sametyakut/EE464-TERM-RPOJECT/altium/component_side.jpeg

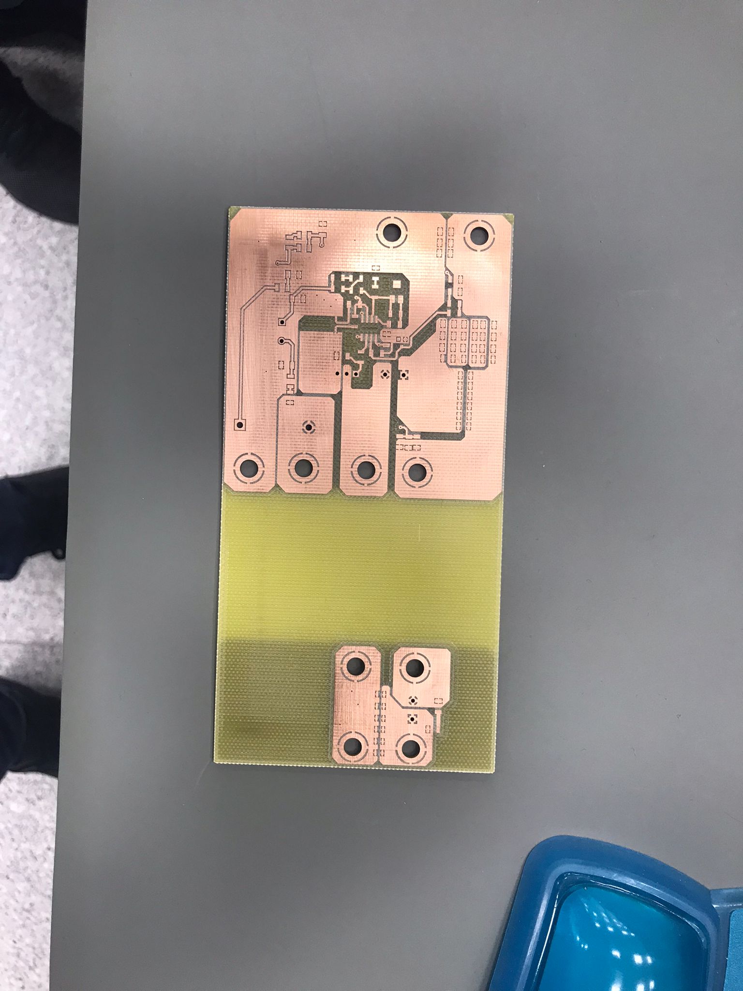
altium/component_side.jpeg
