sametyakut/EE464-TERM-RPOJECT/Magnetic Design/Magnetizing.jpg

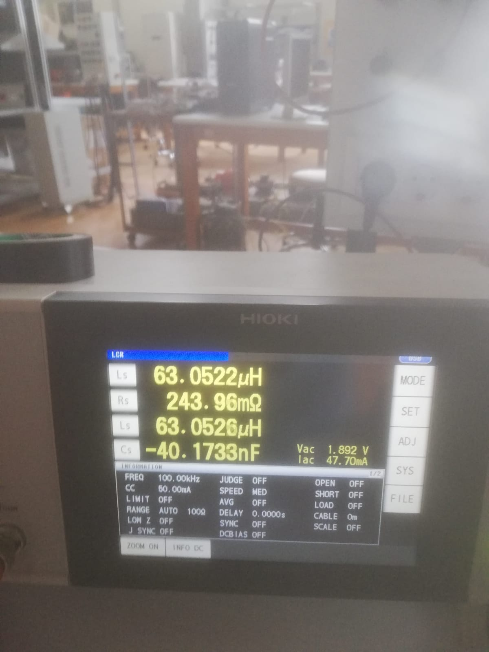
Magnetic Design/Magnetizing.jpg
