sametyakut/EE464-TERM-RPOJECT/Sim/Snubber design.xlsx

Vsn | 140.00
Lleak | 2.47e-06
Ipeak | 7.00
Vo | 16.00
fs | 44000.00
Psn | 3.01
Rsn | 6519.795993
