sametyakut/EE464-TERM-RPOJECT/altium/back_side.jpeg

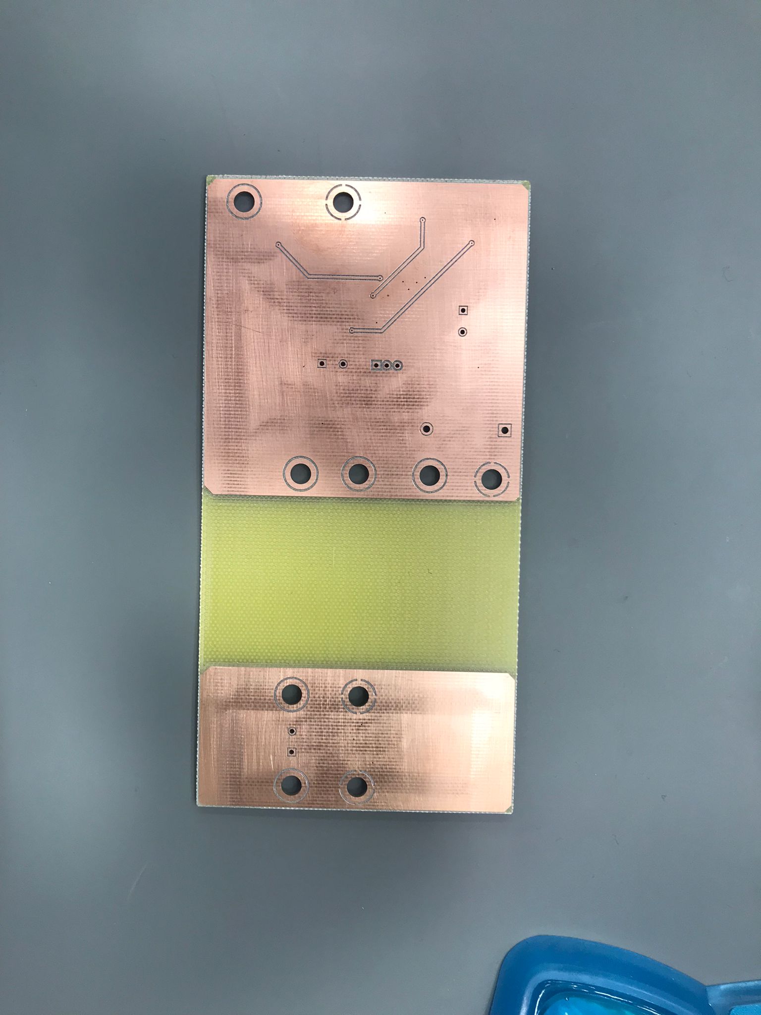
altium/back_side.jpeg
