sametyakut/EE464-TERM-RPOJECT/Magnetic Design/Leakage.jpg

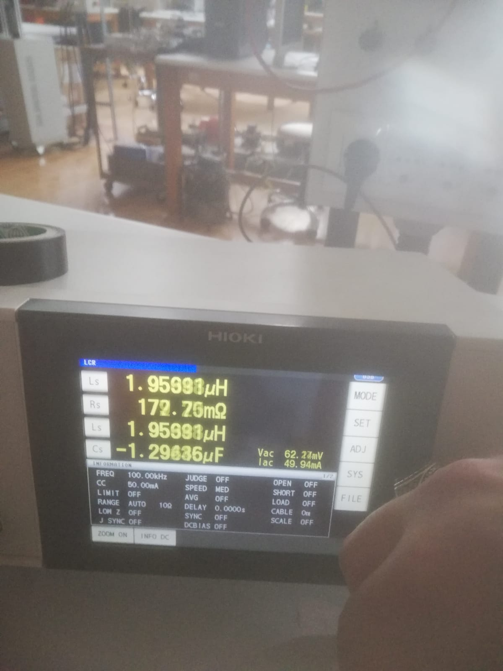
Magnetic Design/Leakage.jpg
