sametyakut/EE464-TERM-RPOJECT/Sim/schematic_jun_05.png

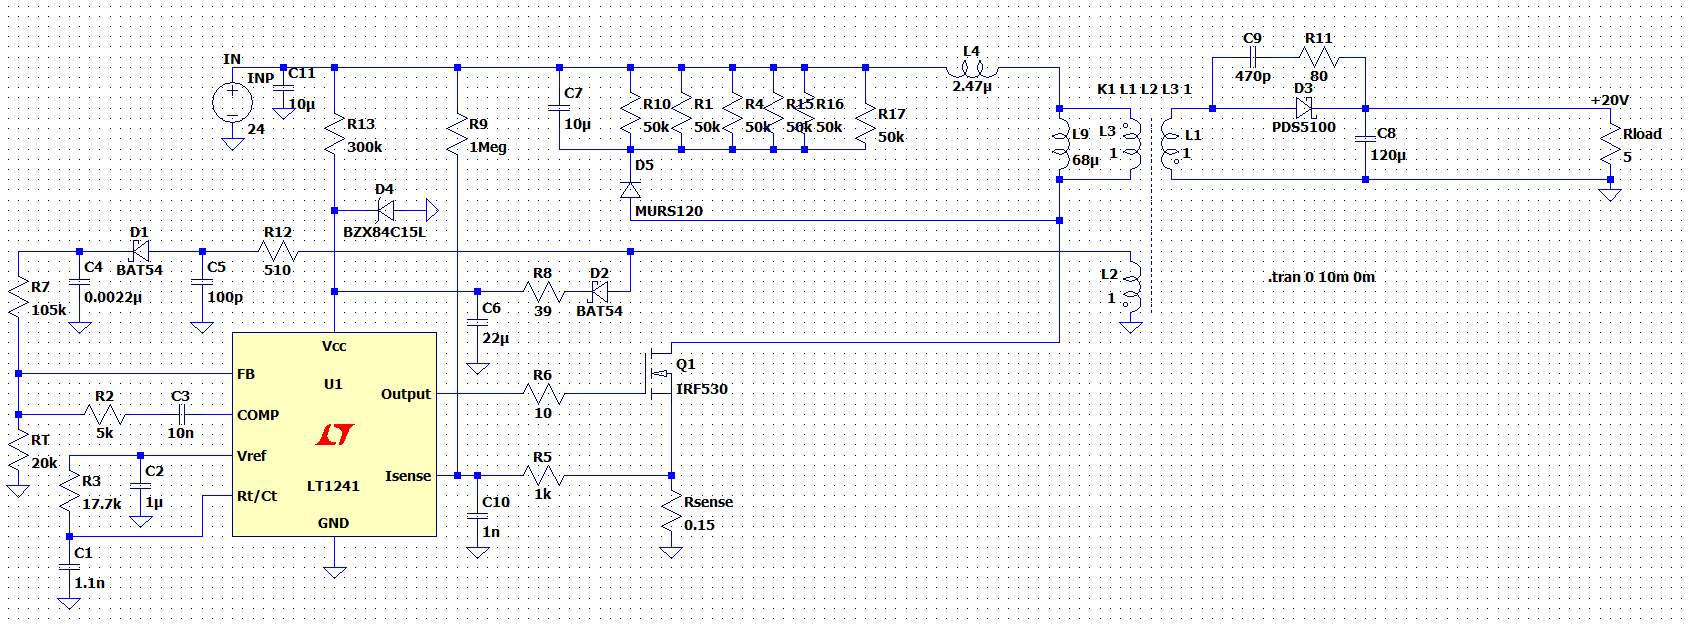
Sim/schematic_jun_05.png
