sametyakut/EE464-TERM-RPOJECT/Sim/UpdatedCircuit_Jun20.png

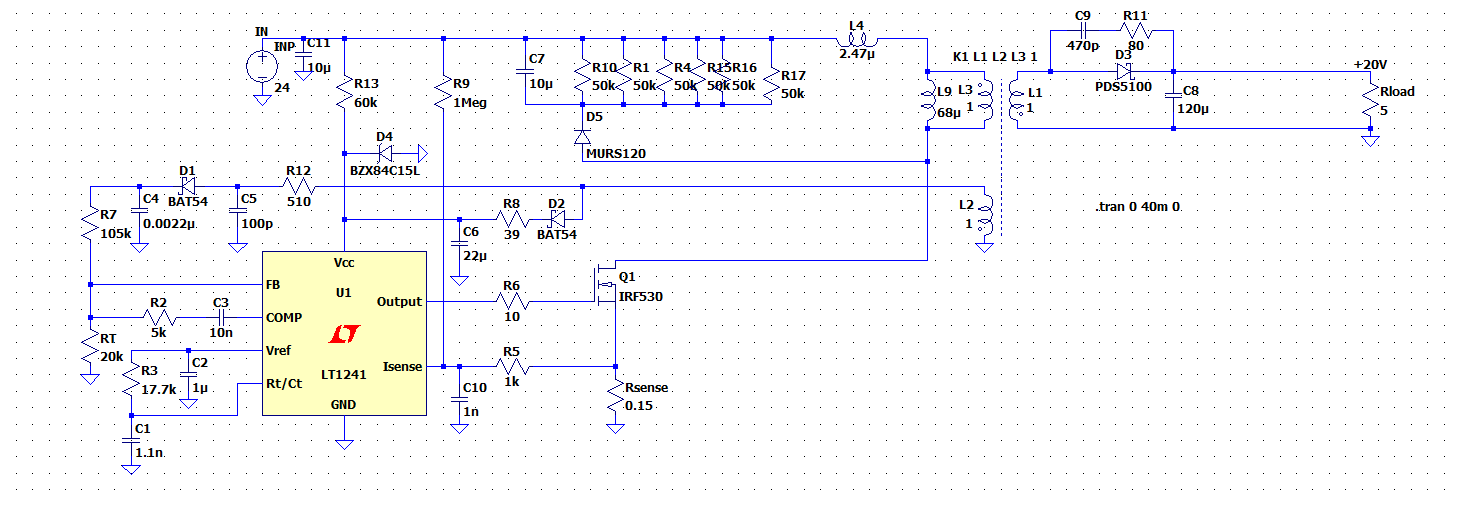
Sim/UpdatedCircuit_Jun20.png
