sametyakut/EE464-TERM-RPOJECT/altium/BOM.xlsx

Comment | Description | Designator | Footprint | LibRef | Quantity
1NF | CAP,1UF(16V,10%,CER,X7R,SMD-1206) | C1, C3 | 1206N | 10023689-135 | 2
1UF | CAP,1UF(16V,10%,CER,X7R,SMD-1206) | C2, C20 | 1206N | 10023689-135 | 2
2.2NF | CAP,1UF(16V,10%,CER,X7R,SMD-1206) | C4 | 1206N | 10023689-135 | 1
100PF | CAP,1UF(16V,10%,CER,X7R,SMD-1206) | C5,C10 | 1206N | 10023689-135 | 1
22UF | CAP,1UF(16V,10%,CER,X7R,SMD-1206) | C6 | 1206N | 10023689-135 | 1
10UF | CAP,1UF(16V,10%,CER,X7R,SMD-1206) | C7, C7_1, C7_2, C7_3, C7_4, C7_5, C7_6, C7_7, C7_8, C15, C15_2, C15_3, C17, C17_2, C17_3 | 1206N | 10023689-135 | 15
22UF | CAP,22UF(25VDC,20%,CER,X5R,SMD-0805) | C8, C9, C11, C12, C13, C14 | 0805L | 30000061 | 6
470PF | CAP,1UF(16V,10%,CER,X7R,SMD-1206) | C16 | 1206N | 10023689-135 | 1
100NF | CAP,1UF(16V,10%,CER,X7R,SMD-1206) | CG | 1206N | 10023689-135 | 1
MBR560 | Schottky Rectifier | D1 | TO-220AC | Diode 10TQ035 | 1
SR5100 | 3 Amp General Purpose Rectifier | D2 | DO-201AD | Diode 1N5401 | 1
MBR10100 | Schottky Rectifier | D3 | TO-220AC | Diode 10TQ035 | 1
BZX84C15LT1 | DIODE(ZNR,15V,SOT-23) | D4 | SOT23_190P290X240X111_3 | 5961-1315-0002 | 1
MBR10150 | Schottky Rectifier | D5 | TO-220AC | Diode 10TQ035 | 1
NMOS-2 | N-Channel Power MOSFET | Q1 | TO-220AB | NMOS-2 | 1
470M OHM | RES,3M(THFL,2W,1%,SMD-2512) | R1_1, R1_2, R1_3 | 2512N | 30007383 | 3
0 OHM | RES,0R(THFL,0.250W,0%,SMD-1206) | R2_1, R3_2, R7_1 | 1206L | 10023672-5 | 3
10K OHM | POT,10KR(CRMT_LIN,0.25W,10%,MULT,SMD) | R2_2 | pot_3224j | 5905-9993-1034 | 1
15K OHM | RES,0R(THFL,0.250W,0%,SMD-1206) | R3_1 | 1206L | 10023672-5 | 1
2.7K OHM | RES,0R(THFL,0.250W,0%,SMD-1206) | R3_3, R7_2, R7_3 | 1206L | 10023672-5 | 3
10K OHM | RES,0R(THFL,0.250W,0%,SMD-1206) | R4_1, R4_2 | 1206L | 10023672-5 | 2
1K OHM | RES,0R(THFL,0.250W,0%,SMD-1206) | R5 | 1206L | 10023672-5 | 1
10R OHM | RES,0R(THFL,0.250W,0%,SMD-1206) | R6 | 1206L | 10023672-5 | 1
100K OHM | RES,0R(THFL,0.250W,0%,SMD-1206) | R7_4, R13_1, R13_2, R13_3 | 1206L | 10023672-5 | 4
39R OHM | RES,0R(THFL,0.250W,0%,SMD-1206) | R8 | 1206L | 10023672-5 | 1
1MEG OHM | RES,0R(THFL,0.250W,0%,SMD-1206) | R9, R14_1, R14_2, R14_3 | 1206L | 10023672-5 | 4
47K OHM | RES,0R(THFL,0.250W,0%,SMD-1206) | R10_1, R10_2, R10_3, R10_4, R10_5, R10_6 | 1206L | 10023672-5 | 6
80 OHM | RES,0R(THFL,0.250W,0%,SMD-1206) | R11 | 1206L | 10023672-5 | 1
120R OHM | RES,0R(THFL,0.250W,0%,SMD-1206) | R12_1 | 1206L | 10023672-5 | 1
390R OHM | RES,0R(THFL,0.250W,0%,SMD-1206) | R12_2 | 1206L | 10023672-5 | 1
UC3845D8 | No Description Available | U1 | D8 | UC3845D8 | 1
