sametyakut/EE464-TERM-RPOJECT/components/component list.xlsx

Component | Value | DIRENC.NET
R1(RSense) | 0.3 | 3*0.1R
R2 | 10k | 1*10k
R3 | 3k(2952) | 15k+2.7k | Hesap Uc3845 göre değişti 17Kohm olacak
R4(RT) | 20k | 2*10k
R5 | 5k | 10k??
R6 | 12 | 10R
R7 | 102k | 100k+10k
R8 | 39 | 1*39R
R9 | 1meg | 1*1meg
R10 | 100k | 1*100k
R11 | Copper loss
R12 | 510 | 120R+390R
R13 | 300k | 3*100k
C1 | 1n/50V | 1*1n
C2 | 1u/50V | 1*1u
C3 | 10n/50V | 1*10n
C4 | 2.2n/50V | 1*2.2n
C5 | 100p/50V | 1*100p
C6 | 22u/16V | 1*22u
C7 | 1u | 1*1u
C8 | 5u | Çıkış
C9 | 100u | Çıkış | 100u 6.3V var
C10 | 1n | 1*1n
D1 | BAT467
D2 | BAT467
D3 | SR5100
D4 | BZX84C15L
D5 | SR5100
