sametyakut/EE464-TERM-RPOJECT/APPLICATION NOTES/How to Design a Flyback Converter in Seven Steps _ Article _ MPS_files/1_52.png

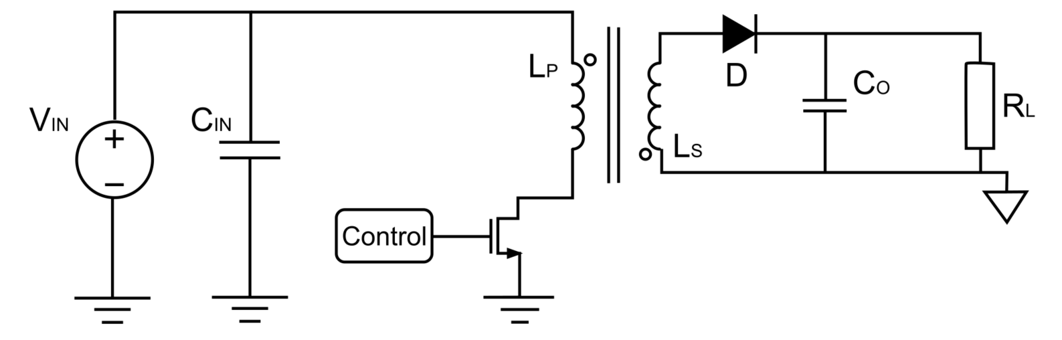
APPLICATION NOTES/How to Design a Flyback Converter in Seven Steps _ Article _ MPS_files/1_52.png
