sametyakut/EE464-TERM-RPOJECT/altium/schematic.pdf

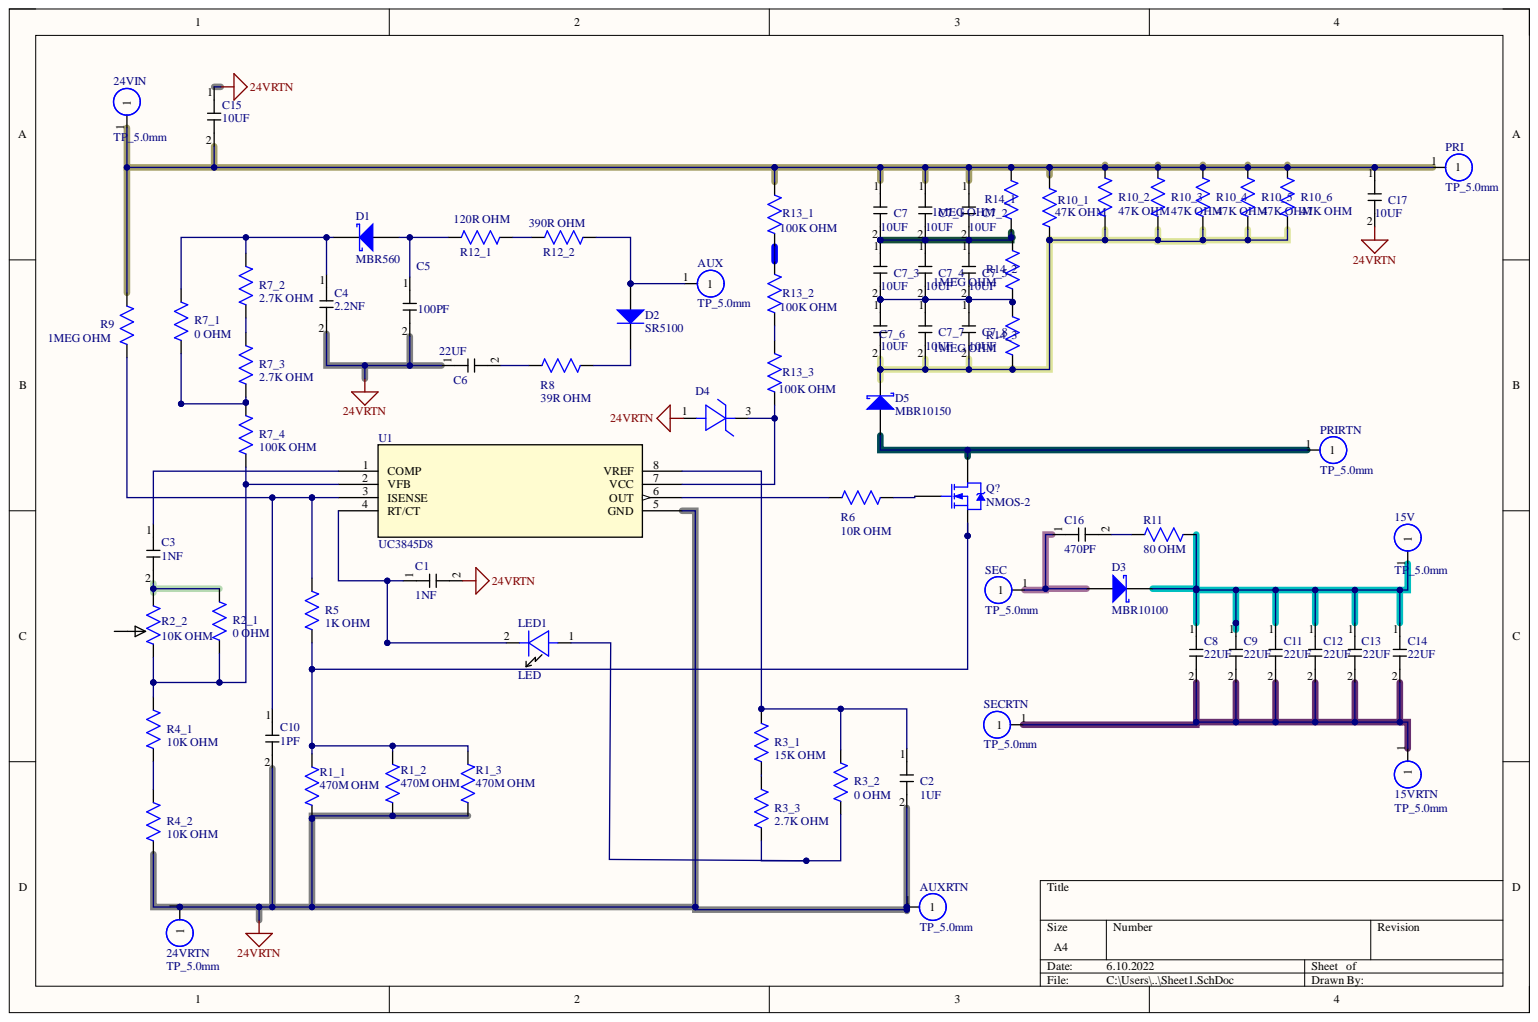
[picture p78: page 1]

R3_3
2.7K OHM
