sametyakut/EE464-TERM-RPOJECT/altium/layout.pdf

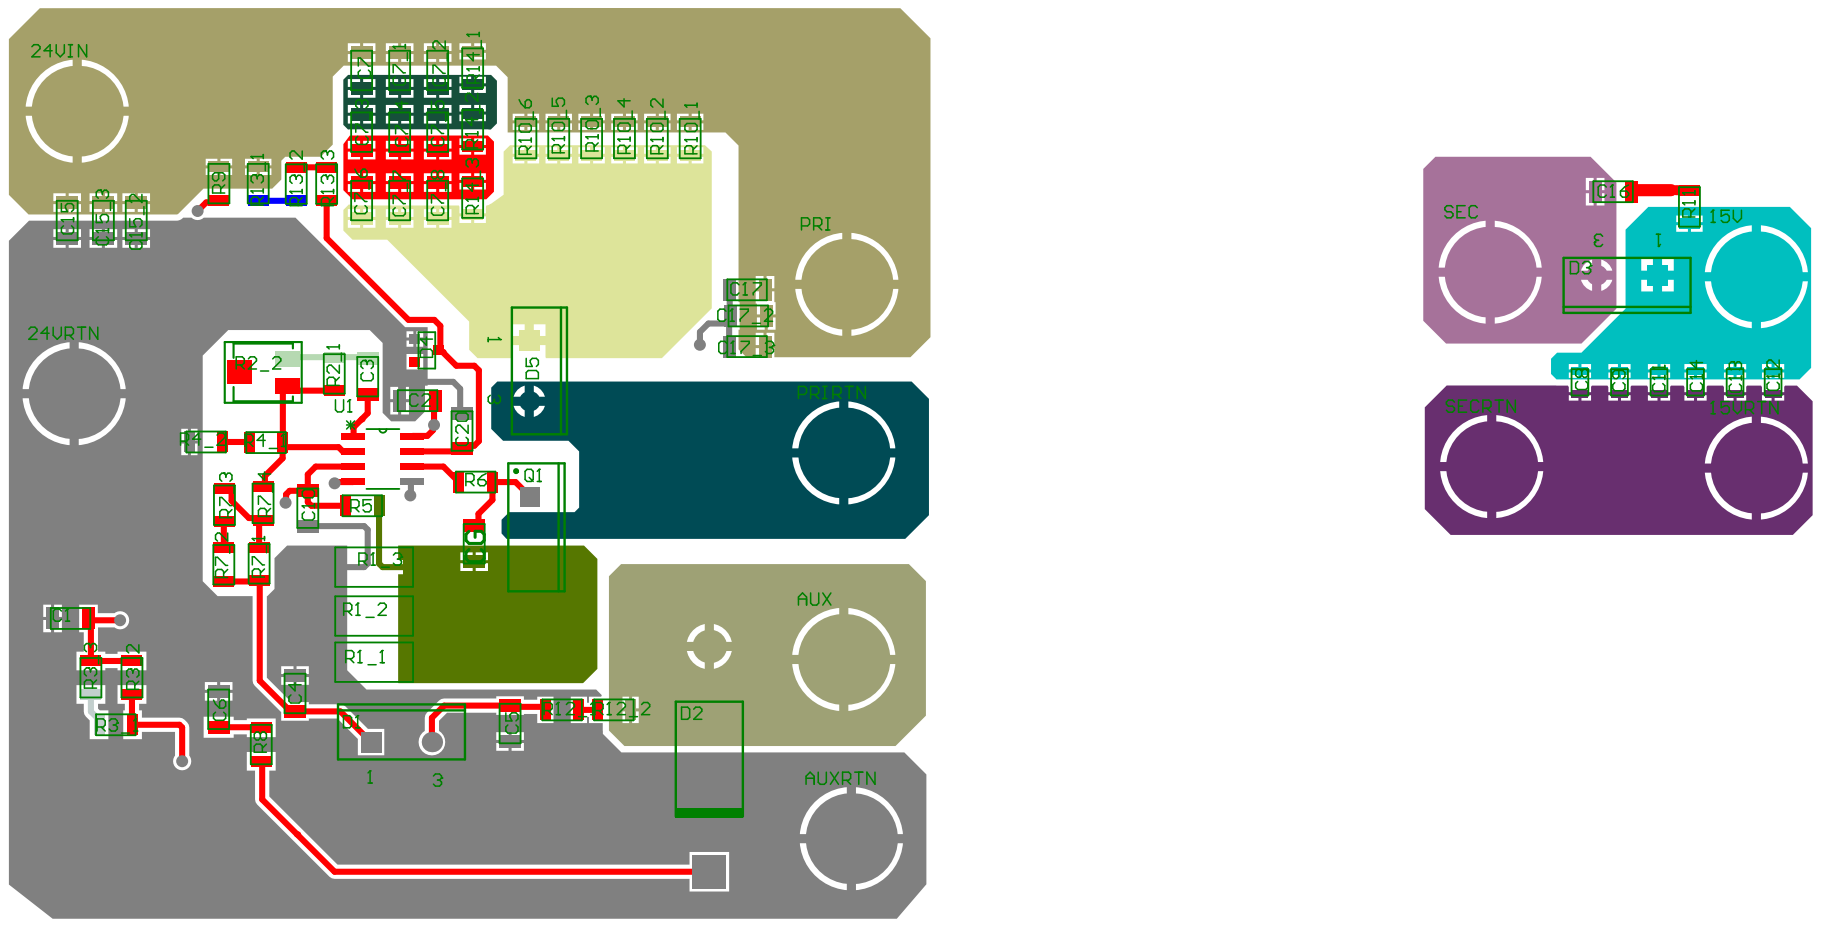
[picture p79: page 1]
