sametyakut/EE464-TERM-RPOJECT/altium/overlay.pdf

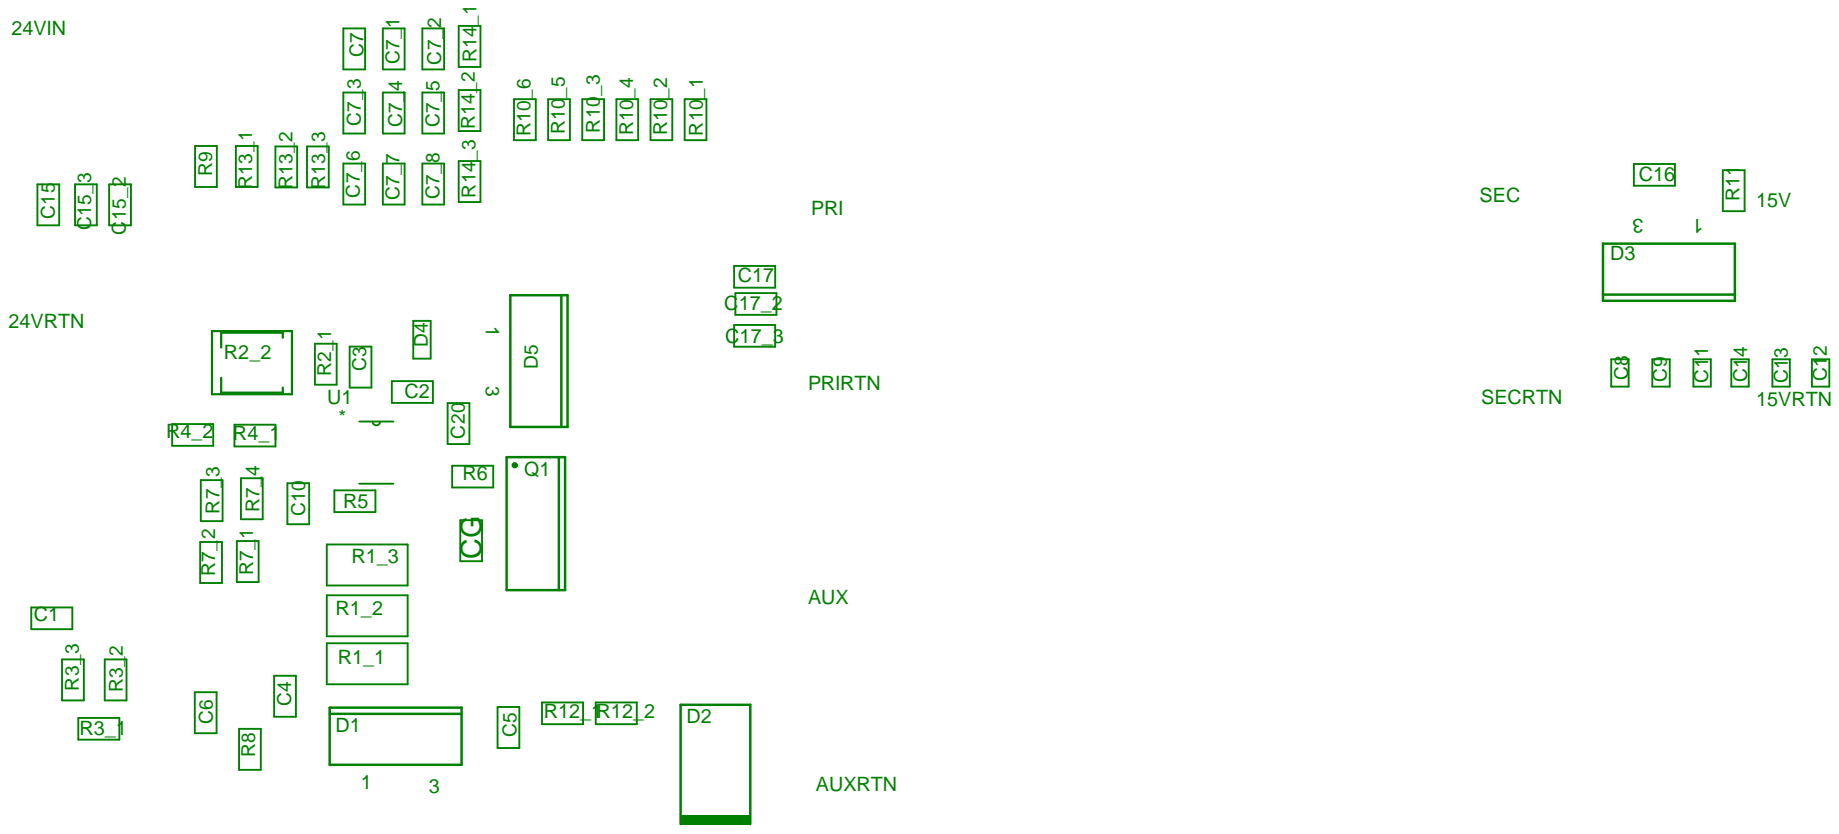
[picture p80: page 1]
