sametyakut/EE464-TERM-RPOJECT/Sim/newsim.asc

C1: cap; 1.1n
C2: cap; 1µ
C3: cap; 10n
C4: cap; 0.0022µ
C5: cap; 100p
C6: cap; 22µ
C7: cap; 10µ
C8: cap; 120µ; Rser=.001
C9: cap; 470p
C10: cap; 1n
C11: cap; 10µ
D1: schottky; BAT54
D2: schottky; BAT54
D3: schottky; PDS5100
D4: zener; BZX84C15L
D5: diode; MURS120
INP: VOLTAGE; 24
L1: ind2; 1; Rser=.05 Rpar=2K
L2: ind2; 1; Rser=.1
L3: ind2; 1; Rser=.05 Rpar=5K
L4: ind; 2.47µ
L9: ind; 68µ
Q1: NMOS; IRF530
R1: res; 50k
R2: res; 5k
R3: res; 17.7k
R4: res; 50k
R5: res; 1k
R6: res; 10
R7: res; 105k
R8: res; 39
R9: res; 1Meg
R10: res; 50k
R11: res; 80
R12: res; 510
R13: res; 60k
R15: res; 50k
R16: res; 50k
R17: res; 50k
Rload: res; 5
Rsense: RES; 0.15
RT: res; 20k
U1: LT1241
Named nets: 0, +20V, IN
.tran 0 40m 0
K1 L1 L2 L3 1
