sametyakut/EE464-TERM-RPOJECT/Sim/openloop.asc

C7: cap; 470p
C8: cap; 50µ; Rser=.1
C9: polcap; 100µ; Rser=.1
D3: schottky; MBRS340
D5: diode; MURS320
L1: ind2; 1; Rser=.05 Rpar=2K
L2: ind2; 1; Rser=.05 Rpar=5K
L4: ind; 60µ
Q1: NMOS; Si7802DN
R10: res; 10K
Rload1: res; 5
V1: VOLTAGE; 24
V2: VOLTAGE; PULSE(0 5 0 0.001m 0.001m 9u 19.7u)
Named nets: 0, Out, IN
.tran 12m
K0.988 L1 L2 1
