sametyakut/EE464-TERM-RPOJECT/Sim/1241(UC3845).asc

C1: cap; 1.1n
C2: cap; .1µ
C3: cap; .01µ
C4: cap; .0022µ
C5: cap; 100p
C6: cap; 22µ
C7: cap; 470p
C8: cap; 5µ; Rser=.1
C9: polcap; 50µ; Rser=.1
C10: cap; 10n
D1: schottky; BAT54
D2: schottky; BAT54
D3: schottky; MBRS340
D4: zener; BZX84C15L
D5: diode; MURS320
L1: ind2; 1; Rser=.05 Rpar=2K
L2: ind2; 1; Rser=.1
L3: ind2; 1; Rser=.05 Rpar=5K
L5: ind; 86µ
Q1: NMOS; Si7802DN
R1: RES; .15
R2: res; 200K
R3: res; 13k
R4: res; 20k
R5: res; 1k
R6: res; 12
R7: res; 110k
R8: res; 39
R9: res; 1Meg
R10: res; 10K
R12: res; 510
R13: res; 300k
Rload: res; 5
U1: LT1241
V1: VOLTAGE; 24
Named nets: 0, +20V, IN
.tran 12m
K1 L1 L2 L3 1
