sametyakut/EE464-TERM-RPOJECT/(commit log)

2022-04-26 Addition on magnetic design
2022-04-26 Magnetic Design with the Toroids added
    With the help of version 2, we are capable of doing the magnetic design with both toroids and EE cores present in the laboratory. There are a couple of suitable toroids and EE cores are available in the laboratory.
2022-05-15 Output capacitance calculations
    For the limit cases. The capacitances calculated here are quite low, but the LTSpice simulations point that even capacitances of 1mF fail to satisfy a 0.03 ripple ratio. (stuck at 0.04)
2022-05-15 open-loop schematic added
2022-05-15 MOSFET datasheet is added
2022-05-15 Inductance values added.
    Inductance values for the transformer:
    - Leakage inductance,
    - Magnetizing inductance.
2022-05-15 Diode datasheet added.
    An SR5100, available in Turkey, seems appropriate as our output diode.
2022-05-15 Reports added
    Complete simulation report (both .docx and .pdf extensions)
    - Topology selection
    - Magnetic design
    - Controller selection
    - Open loop sim.
    - Closed loop sim.
    - Component Selection
2022-05-22 New Version of Magnetic Design Added
2022-05-22 New parallel wire numbers calculated
2022-05-22 New closed loop simulation added.
    - Ripple issue fixed.
    - Frequency fixed.
    - Vout varies significantly (0.7V difference in switching from high load to low load conditions)
2022-05-23 Closed Loop Simulation updated.
    - Ripple fixed.
    - Output voltages adjusted to stay closer to 15V.
    - Line regulation is at around 1% for fixed load currents.
    - Load regulation is somewhat problematic (0.0335 for min. input and 0.04533 for max input) and monotonically increases for increasing inputs.
2022-06-01 Some changes on sim and component list added
    [component list.xlsx]
2022-06-02 Some changes on the circuit are done and regulation calculation is added
    [REGULATION.xlsx]
2022-06-03 Snubber design is added
    [Snubber design.xlsx]
2022-06-05 Snubber design guidelines
    Some tips for primary RCD clamp and secondary RC snubber
2022-06-05 Finalized closed loop circuit
2022-06-15 PCB design documents are added
    [BOM.xlsx]
2022-06-19 Circuit update
    Needed revision of the 300kOhm resistor connected to the Vcc pin of the controller.
    Demanded by our first practical test w/ the PCB.
    Vcc did not reach the critical 15V level to turn on.
    The Zener diode will be changed due to its clamping at 8.6V.
    A resistance of 60k may be required at least to ensure the controller turns on.
